alepape1/weather-station-ESP/ESP_monitor_server/ESP_monitor_server.ino

// MeteoStation — Firmware v3
// Compatible con ESP32 (con pantalla ST7789 240×135) y ESP8266 (sin pantalla)
// Sensores: MCP9808, HTU2x, SparkFun MicroPressure, TSL2584/APDS, anemómetro, veleta
// Tres temporizadores independientes: 100ms viento / 1s pantalla / 20s envío

// ── Detección de plataforma ───────────────────────────────────────────────────
#ifdef ESP8266
  #include <ESP8266WiFi.h>
  #include <ESP8266HTTPClient.h>
  #include <WiFiClient.h>
  #include <ArduinoOTA.h>
  #define I2C_SDA          4
  #define I2C_SCL          5
  #define DHTPIN          14   // D5
  #define ADC_VOLTAGE_REF  3.2f
  #define ADC_RANGE        1024.0f
  #define ANEMOMETER_PIN   A0
  #define RELAY_PIN       12   // D6 — GPIO libre para relay electroválvula
#else  // ESP32
  #include "WiFi.h"
  #include <HTTPClient.h>
  #include <WiFiClientSecure.h>
  #include <ArduinoOTA.h>
  #include "driver/rtc_io.h" // Añade esto al principio del archivo
  #define I2C_SDA          21
  #define I2C_SCL          22
  #define DHTPIN           15
  #define ADC_VOLTAGE_REF  3.41f
  #define ADC_RANGE        4096.0f
  #define ANEMOMETER_PIN   37
  #define VANE_PIN         36
  #if DEVICE_PROFILE == PROFILE_METEO
    #define SOIL_PIN         33   // YL-69 humedad suelo (ADC1_CH5) — solo PROFILE_METEO
    #define SOIL_RAW_DRY   3300   // ADC en tierra seca (~0%) — ajustar con valor raw del serial
    #define SOIL_RAW_WET   1000   // ADC en tierra saturada (~100%) — ajustar con valor raw del serial
  #endif
  #define HAS_DISPLAY
  #define RELAY_PIN        26   // GPIO libre para relay electroválvula
#endif

// ── Pipeline — constantes físicas del simulador ───────────────────────────────
#define PIPELINE_STATIC_P   3.50f  // bar — presión estática (válvula cerrada)
#define PIPELINE_DYNAMIC_P  2.80f  // bar — presión dinámica a caudal nominal
#define PIPELINE_NOISE_P    0.04f  // bar — dispersión sensor de presión
#define PIPELINE_NOISE_Q    0.12f  // L/min — dispersión caudalímetro
#define PIPELINE_NOMINAL_Q  5.00f  // L/min — caudal nominal del sistema

#include <SPI.h>
#include <Wire.h>
#include <Adafruit_MCP9808.h>
#include <SparkFun_MicroPressure.h>
#include <DHTesp.h>
#include <ArduinoJson.h>
#include <math.h>
#include "secrets.h"

// ── Perfiles de dispositivo (definir DEVICE_PROFILE en secrets.h) ─────────────
#define PROFILE_METEO       1   // ECU meteorológica — 1 relay (GPIO RELAY_PIN)
#define PROFILE_IRRIGATION  2   // ECU irrigación   — 4 relays (GPIOs RELAY_PIN_1..4)

#ifndef DEVICE_PROFILE
  #define DEVICE_PROFILE PROFILE_METEO
#endif

#if DEVICE_PROFILE == PROFILE_IRRIGATION
  #define RELAY_COUNT 4
  #ifndef RELAY_PIN_1
    // ESP32 4-Relay Board (ESPHome): GPIO32/33/25/26, LED status GPIO23
    #define RELAY_PIN_1 32
    #define RELAY_PIN_2 33
    #define RELAY_PIN_3 25
    #define RELAY_PIN_4 26
  #endif
  static const uint8_t RELAY_PINS[RELAY_COUNT] = {RELAY_PIN_1, RELAY_PIN_2,
                                                   RELAY_PIN_3, RELAY_PIN_4};
#else
  #define RELAY_COUNT 1
  static const uint8_t RELAY_PINS[RELAY_COUNT] = {RELAY_PIN};
#endif

#ifdef HAS_DISPLAY
  #include <TFT_eSPI.h>
#endif

// ── Credenciales (definidas en secrets.h) ─────────────────────────────────────
const char* ssid        = WIFI_SSID;
const char* password    = WIFI_PASSWORD;
const char* server_ip   = SERVER_IP;
const int   server_port = SERVER_PORT;

// ── Pines ─────────────────────────────────────────────────────────────────────
const int ledPin = 2;
#define LED_ON  LOW
#define LED_OFF HIGH

// ── Intervalos ─────────────────────────────────────────────────────────────────
#define WIND_MS       100
#define SCREEN_MS    1000
#define SEND_MS      2000
#define RELAY_MS     2000   // Consulta estado relay cada 2s para respuesta casi inmediata

#ifdef HAS_DISPLAY
#define DISPLAY_TIMEOUT_MS 60000UL  // Apagar pantalla tras 60s sin actividad
#define BTN_LEFT   0                // Botón izquierdo (BOOT), INPUT_PULLUP, activo LOW
#define BTN_RIGHT 35                // Botón derecho, activo LOW
#endif

// ── Objetos ────────────────────────────────────────────────────────────────────
SparkFun_MicroPressure barometer;
Adafruit_MCP9808       tempsensor = Adafruit_MCP9808();
DHTesp                 dht;

#ifdef HAS_DISPLAY
  TFT_eSPI    tft = TFT_eSPI();
  TFT_eSprite spr = TFT_eSprite(&tft);
  unsigned long lastActivityTime = 0;
  bool          displayOn        = true;
#endif

// ── Relay electroválvula(s) ────────────────────────────────────────────────────
// JQC-3FF-S-Z activo-LOW: LOW = relay ON (válvula abierta), HIGH = relay OFF
// relayActive[i] — estado actual de cada relay (índice = bit en bitmask)
bool relayActive[RELAY_COUNT] = {};

// ── Flags de sensor ────────────────────────────────────────────────────────────
bool mcp_ok = false;
bool bar_ok = false;
bool htu_ok = false;
bool dht_ok = false;
bool tsl_ok = false;

// ── Valores medidos ────────────────────────────────────────────────────────────
float  temperatureMCP    = 0;
float  temperatureDHT    = 0;   // HTU2x temperatura
float  humidity          = 0;   // HTU2x humedad
float  temperatureDHT11  = 0;   // DHT11 temperatura
float  humidityDHT11     = 0;   // DHT11 humedad
double pressure          = 0;
float  windSpeed         = 0;
float  windSpeedFiltered = 0;
float  currentWindDirDeg = 0;
float  lightLevel        = 0;
float  soilMoisture      = 0;   // YL-69 — humedad suelo (0=seco, 100=saturado)

// ── Valores simulados (drift lento) ───────────────────────────────────────────
float sim_tempMCP   = 20.5f;
float sim_tempDHT   = 19.8f;
float sim_humidity  = 62.0f;
float sim_tempDHT11 = 20.1f;
float sim_humDHT11  = 60.0f;
float sim_pressure  = 101.3f;
float sim_light     = 300.0f;
float sim_windSpeed = 3.5f;
float sim_windDir        = 180.0f;
float sim_soilMoisture   = 50.0f;

// ── Pipeline simulado ─────────────────────────────────────────────────────────
String pipelineScenario      = "normal";  // actualizado desde el servidor cada 20s
float  sim_pipeline_pressure = PIPELINE_STATIC_P;
float  sim_pipeline_flow     = 0.0f;

static float driftClamp(float v, float mn, float mx, float step) {
  float d = ((float)random(-100, 101) / 100.0f) * step;
  return constrain(v + d, mn, mx);
}

void updateSimulatedValues() {
  sim_tempMCP   = driftClamp(sim_tempMCP,   -10.0f,  45.0f,  0.05f);
  sim_tempDHT   = driftClamp(sim_tempDHT,   -10.0f,  45.0f,  0.05f);
  sim_humidity  = driftClamp(sim_humidity,   20.0f,  95.0f,  0.20f);
  sim_tempDHT11 = driftClamp(sim_tempDHT11, -10.0f,  45.0f,  0.05f);
  sim_humDHT11  = driftClamp(sim_humDHT11,   20.0f,  95.0f,  0.20f);
  sim_pressure  = driftClamp(sim_pressure,   95.0f, 110.0f,  0.02f);
  sim_light     = driftClamp(sim_light,       0.0f, 2000.0f, 5.0f);
  sim_windSpeed = driftClamp(sim_windSpeed,   0.0f,   15.0f, 0.3f);
  sim_windDir        = fmod(sim_windDir + ((float)random(-10, 11) / 10.0f) * 5.0f + 360.0f, 360.0f);
  sim_soilMoisture   = driftClamp(sim_soilMoisture, 0.0f, 100.0f, 0.5f);
}

// ── Pipeline simulator ────────────────────────────────────────────────────────
// Ruido determinista idéntico al de pipeline_sim.py: tres ondas sinusoidales.
// Reproducible y sin random() → facilita comparar resultados con el backend.
static float pipelineNoise(float t_s, int ch) {
  return sinf(t_s *  7.3f + ch * 1.7f) * 0.55f
       + sinf(t_s * 13.1f + ch * 3.2f) * 0.30f
       + sinf(t_s * 31.7f + ch * 5.1f) * 0.15f;
}

void updatePipelineSimValues() {
  float t       = millis() / 1000.0f;
  float p_noise = pipelineNoise(t, 0) * PIPELINE_NOISE_P;
  float q_noise = pipelineNoise(t, 1) * PIPELINE_NOISE_Q;

  if (pipelineScenario == "burst") {
    sim_pipeline_pressure = max(0.0f, 0.25f + p_noise * 0.4f);
    sim_pipeline_flow     = relayActive[0]
      ? max(0.0f, PIPELINE_NOMINAL_Q * 0.08f + fabsf(q_noise) * 0.3f)
      : 0.0f;

  } else if (pipelineScenario == "leak") {
    if (relayActive) {
      sim_pipeline_pressure = max(0.0f, PIPELINE_DYNAMIC_P - 0.18f + p_noise);
      sim_pipeline_flow     = max(0.0f, PIPELINE_NOMINAL_Q - 0.45f + q_noise);
    } else {
      sim_pipeline_pressure = max(0.0f, PIPELINE_STATIC_P - 0.10f + p_noise);
      sim_pipeline_flow     = max(0.0f, 0.28f + fabsf(q_noise) * 0.35f);
    }

  } else {  // "normal"
    if (relayActive) {
      sim_pipeline_pressure = max(0.0f, PIPELINE_DYNAMIC_P + p_noise);
      sim_pipeline_flow     = max(0.0f, PIPELINE_NOMINAL_Q + q_noise);
    } else {
      sim_pipeline_pressure = max(0.0f, PIPELINE_STATIC_P + p_noise);
      sim_pipeline_flow     = max(0.0f, fabsf(q_noise) * 0.05f);
    }
  }
}

// =============================================================================
// HTU2x (HTU21D / HTU20D / SHT21) — temperatura y humedad por I2C
// Dirección fija: 0x40. Sin librería externa.
// =============================================================================
#define HTU2X_ADDR        0x40
#define HTU2X_CMD_TEMP    0xF3   // medir temperatura, no-hold master
#define HTU2X_CMD_HUM     0xF5   // medir humedad,     no-hold master
#define HTU2X_CMD_RESET   0xFE
#define HTU2X_CMD_WR_REG  0xE6   // escribir registro de usuario
#define HTU2X_CMD_RD_REG  0xE7   // leer registro de usuario
// Registro de usuario: bit7+bit0=resolución, bit2=calefactor, bit1=OTP_disable
// 0x02 → 12/14 bit, calefactor OFF, OTP desactivado (default tras reset)
// 0x06 → 12/14 bit, calefactor ON,  OTP desactivado
#define HTU2X_REG_DEFAULT 0x02
#define HTU2X_REG_HEATER  0x06

bool htu_begin() {
  Wire.beginTransmission(HTU2X_ADDR);
  Wire.write(HTU2X_CMD_RESET);
  if (Wire.endTransmission() != 0) return false;
  delay(15);  // tiempo de reset (máx 15 ms según datasheet)
  return true;
}

// Lanza una medición y espera. Devuelve NAN si falla.
static float htu_measure(uint8_t cmd, uint16_t wait_ms) {
  Wire.beginTransmission(HTU2X_ADDR);
  Wire.write(cmd);
  if (Wire.endTransmission() != 0) return NAN;
  delay(wait_ms);
  Wire.requestFrom((uint8_t)HTU2X_ADDR, (uint8_t)3, (uint8_t)1);
  if (Wire.available() < 2) return NAN;
  uint16_t raw = ((uint16_t)Wire.read() << 8) | Wire.read();
  if (Wire.available()) Wire.read();  // descarta CRC
  raw &= 0xFFFC;  // limpia los 2 bits de tipo de medición
  return (float)raw;
}

float htu_readTemp() {
  float raw = htu_measure(HTU2X_CMD_TEMP, 50);
  if (isnan(raw)) return NAN;
  return -46.85f + 175.72f * (raw / 65536.0f);
}

float htu_readHumidity() {
  float raw = htu_measure(HTU2X_CMD_HUM, 20);
  if (isnan(raw)) return NAN;
  return constrain(-6.0f + 125.0f * (raw / 65536.0f), 0.0f, 100.0f);
}

// Activa o desactiva el calefactor interno del HTU2x.
static void htu_set_heater(bool on) {
  Wire.beginTransmission(HTU2X_ADDR);
  Wire.write(HTU2X_CMD_WR_REG);
  Wire.write(on ? HTU2X_REG_HEATER : HTU2X_REG_DEFAULT);
  Wire.endTransmission();
}

// Calentamiento de arranque: activa el calefactor ~3 s para evaporar
// condensación y obtener lecturas de humedad más fiables desde el inicio.
void htu_heater_warmup() {
  Serial.println("HTU2x: calentamiento 3s (evaporar condensacion)...");
  htu_set_heater(true);
  for (int i = 3; i > 0; i--) {
    float t = htu_readTemp();
    float h = htu_readHumidity();
    Serial.printf("  HTU2x heater ON — T:%.1f C  H:%.1f %%  (%ds)\n", t, h, i);
    delay(1000);
  }
  htu_set_heater(false);
  delay(1000);  // estabilización tras apagar calefactor
  Serial.println("HTU2x: calentamiento completado.");
}

// =============================================================================
// Sensor de luz ambiente — autodetección TSL2584 / APDS-9930 (I2C directo)
// Ambos chips usan dirección 0x39 y protocolo CMD=0x80|reg.
// TSL2584:  datos en 0x0C-0x0F, ID en 0x0A (bits[7:4]=0xA)
// APDS-9930: datos en 0x14-0x17, ID en 0x12 (=0x39)
// =============================================================================
#define LIGHT_ADDR     0x39
#define LIGHT_CMD      0x80   // bit CMD obligatorio en el byte de registro

// Registros comunes (misma dirección en ambos chips)
#define LIGHT_CTRL     0x00   // ENABLE / POWER
#define LIGHT_TIMING   0x01   // TIMING (TSL) / ATIME (APDS)

// Registros exclusivos TSL2584
#define TSL_ID_REG     0x0A   // Part number en bits[7:4]; TSL2584 = 0xA
#define TSL_D0L        0x0C   // CH0 low  (visible + IR)
#define TSL_D1L        0x0E   // CH1 low  (IR)

// Registros exclusivos APDS-9930
#define APDS_ID_REG    0x12   // Chip ID; APDS-9930 = 0x39
#define APDS_CDATAL    0x14   // Clear channel low  (visible + IR)
#define APDS_IRDATAL   0x16   // IR channel low

static bool light_is_apds = false;  // se establece en tsl_begin()

static bool light_write(uint8_t reg, uint8_t val) {
  Wire.beginTransmission(LIGHT_ADDR);
  Wire.write(LIGHT_CMD | reg);
  Wire.write(val);
  return Wire.endTransmission() == 0;
}

// Lectura stop-start (más compatible con ESP8266 que repeated-start)
static uint8_t light_read8(uint8_t reg) {
  Wire.beginTransmission(LIGHT_ADDR);
  Wire.write(LIGHT_CMD | reg);
  if (Wire.endTransmission() != 0) return 0xFF;
  Wire.requestFrom((uint8_t)LIGHT_ADDR, (uint8_t)1, (uint8_t)1);
  return Wire.available() ? Wire.read() : 0xFF;
}

static uint16_t light_read16(uint8_t regL) {
  uint16_t lo = light_read8(regL);
  uint16_t hi = light_read8(regL + 1);
  return (hi << 8) | lo;
}

// Enciende el sensor, detecta el tipo y configura la integración.
// Devuelve true si el sensor responde en el bus.
bool tsl_begin() {
  if (!light_write(LIGHT_CTRL, 0x03)) return false;  // Power ON + ALS enable
  delay(10);

  // Autodetección: leer ambos registros de ID y mostrarlos
  uint8_t apds_id = light_read8(APDS_ID_REG);  // 0x12 → 0x39 o 0x30 para APDS-9930
  uint8_t tsl_id  = light_read8(TSL_ID_REG);   // 0x0A → 0xAx para TSL2584
  Serial.printf("[LUZ] ID@0x12=0x%02X  ID@0x0A=0x%02X\n", apds_id, tsl_id);

  // APDS-9930: ID puede ser 0x39 (rev1) o 0x30 (rev0); nibble alto = 0x3
  if ((apds_id & 0xF0) == 0x30) {
    light_is_apds = true;
    // ATIME=0xDB → 37 ciclos × 2.73 ms ≈ 101 ms por conversión
    light_write(LIGHT_TIMING, 0xDB);
    Serial.printf("[LUZ] APDS-9930 detectado (ID=0x%02X)\n", apds_id);
  } else if ((tsl_id & 0xF0) == 0xA0) {
    light_is_apds = false;
    light_write(LIGHT_TIMING, 0x02);  // 402 ms, ganancia 1×
    Serial.printf("[LUZ] TSL2584 detectado (ID=0x%02X)\n", tsl_id);
  } else {
    // ID desconocido — probar APDS-9930 como fallback (más probable en 0x39)
    light_is_apds = true;
    light_write(LIGHT_TIMING, 0xDB);
    Serial.printf("[LUZ] ID desconocido — usando registros APDS-9930 (fallback)\n");
  }

  delay(450);  // Esperar primera integración completa (cubre ambos casos)
  return true;
}

// Devuelve lux estimado a partir del canal visible+IR y el canal IR.
// Usa la fórmula TSL258x (válida también como aproximación para APDS-9930).
float tsl_readLux() {
  uint16_t ch0, ch1;
  if (light_is_apds) {
    ch0 = light_read16(APDS_CDATAL);   // clear (visible + IR)
    ch1 = light_read16(APDS_IRDATAL);  // IR
  } else {
    ch0 = light_read16(TSL_D0L);
    ch1 = light_read16(TSL_D1L);
  }

  if (ch0 == 0) return 0.0f;

  float ratio = (float)ch1 / (float)ch0;
  float lux;

  if      (ratio <= 0.52f) lux = 0.0315f * ch0 - 0.0593f * ch0 * pow(ratio, 1.4f);
  else if (ratio <= 0.65f) lux = 0.0229f * ch0 - 0.0291f * ch1;
  else if (ratio <= 0.80f) lux = 0.0157f * ch0 - 0.0180f * ch1;
  else if (ratio <= 1.30f) lux = 0.00338f * ch0 - 0.00260f * ch1;
  else                     lux = 0.0f;

  return max(0.0f, lux);
}

// ── Filtros media móvil ────────────────────────────────────────────────────────
#define FILTER_SIZE 10

int   anemometerValues[FILTER_SIZE] = {};
int   aneIdx = 0;

float filteredADC(int newVal) {
  anemometerValues[aneIdx] = newVal;
  aneIdx = (aneIdx + 1) % FILTER_SIZE;
  long s = 0;
  for (int i = 0; i < FILTER_SIZE; i++) s += anemometerValues[i];
  return (float)s / FILTER_SIZE;
}

#if defined(SOIL_PIN)
int   soilValues[FILTER_SIZE] = {};
int   soilIdx = 0;

float filteredSoilADC(int newVal) {
  soilValues[soilIdx] = newVal;
  soilIdx = (soilIdx + 1) % FILTER_SIZE;
  long s = 0;
  for (int i = 0; i < FILTER_SIZE; i++) s += soilValues[i];
  return (float)s / FILTER_SIZE;
}
#endif

float adcToWindSpeed(float adc) {
  float v = adc * (ADC_VOLTAGE_REF / ADC_RANGE);
  return (v / ADC_VOLTAGE_REF) * 30.0f;
}

#ifdef HAS_DISPLAY
float adcToWindDeg(int adc) {
  float d = (adc / ADC_RANGE) * 360.0f;
  if (d >= 337.5f || d < 22.5f) return 0.0f;
  if (d < 67.5f)                 return 45.0f;
  if (d < 112.5f)                return 90.0f;
  if (d < 157.5f)                return 135.0f;
  if (d < 202.5f)                return 180.0f;
  if (d < 247.5f)                return 225.0f;
  if (d < 292.5f)                return 270.0f;
  return 315.0f;
}
#else
float adcToWindDeg(int) { return 0.0f; }
#endif

const char* degToCompass(float d) {
  const char* dirs[] = {"N","NE","E","SE","S","SO","O","NO"};
  return dirs[((int)(d + 22.5f) / 45) % 8];
}

// ── FreeRTOS (solo ESP32) — declarado aquí para estar disponible antes de su uso ──
#ifndef ESP8266
volatile bool        isUpdatingOTA = false;
portMUX_TYPE         windMux       = portMUX_INITIALIZER_UNLOCKED;
SemaphoreHandle_t    dataMutex     = nullptr;
TaskHandle_t         networkTaskHandle = nullptr;
#endif

// ── Promedio vectorial de dirección ────────────────────────────────────────────
float windSumX = 0, windSumY = 0;
int   windSampleCount = 0;
float finalAvgWindDir = 0;

void accumulateWindVector(float deg) {
  float r = deg * PI / 180.0f;
#ifndef ESP8266
  portENTER_CRITICAL(&windMux);
#endif
  windSumX += cos(r);
  windSumY += sin(r);
  windSampleCount++;
#ifndef ESP8266
  portEXIT_CRITICAL(&windMux);
#endif
}

float calcAndResetWindVector() {
#ifndef ESP8266
  portENTER_CRITICAL(&windMux);
#endif
  if (windSampleCount == 0) {
#ifndef ESP8266
    portEXIT_CRITICAL(&windMux);
#endif
    return 0;
  }
  float deg = atan2(windSumY, windSumX) * 180.0f / PI;
  if (deg < 0) deg += 360.0f;
  windSumX = windSumY = 0;
  windSampleCount = 0;
#ifndef ESP8266
  portEXIT_CRITICAL(&windMux);
#endif
  return deg;
}

// ── Estado ────────────────────────────────────────────────────────────────────
bool lastServerOK    = false;
unsigned long lastSendTime   = 0;
unsigned long lastScreenTime = 0;


// ── Info estática del hardware ────────────────────────────────────────────────
void printHardwareInfo() {
  Serial.println("\n=== Hardware Info ===");
#ifdef ESP8266
  Serial.printf("Chip         : ESP8266 (ID=0x%08X)\n", ESP.getChipId());
#else
  Serial.printf("Chip         : %s rev%d\n", ESP.getChipModel(), ESP.getChipRevision());
#endif
  Serial.printf("CPU          : %d MHz\n",      ESP.getCpuFreqMHz());
  Serial.printf("Flash        : %d MB\n",        ESP.getFlashChipSize() / (1024 * 1024));
  Serial.printf("Free Heap    : %d bytes\n",     ESP.getFreeHeap());
  Serial.printf("SDK          : %s\n",           ESP.getSdkVersion());
  Serial.printf("MAC          : %s\n",           WiFi.macAddress().c_str());
  Serial.printf("IP           : %s\n",           WiFi.localIP().toString().c_str());
  Serial.println("====================");
}

void postDeviceInfo() {
  JsonDocument doc;
#ifdef ESP8266
  doc["chip_model"]    = "ESP8266";
  doc["chip_revision"] = 0;
#else
  doc["chip_model"]    = ESP.getChipModel();
  doc["chip_revision"] = (int)ESP.getChipRevision();
#endif
  doc["cpu_freq_mhz"]  = ESP.getCpuFreqMHz();
  doc["flash_size_mb"] = ESP.getFlashChipSize() / (1024 * 1024);
  doc["sdk_version"]   = ESP.getSdkVersion();
  doc["mac_address"]   = WiFi.macAddress();
  doc["ip_address"]    = WiFi.localIP().toString();
  doc["relay_count"]   = RELAY_COUNT;

  String json;
  serializeJson(doc, json);

  String url = "https://" + String(server_ip) + "/api/device_info";
#ifdef ESP8266
  WiFiClient wifiClient;
  HTTPClient http;
  http.setTimeout(10000);
  http.begin(wifiClient, url);
#else
  WiFiClientSecure client;
  client.setInsecure();
  client.setHandshakeTimeout(10);
  HTTPClient http;
  http.setTimeout(10000);
  http.begin(client, url);
#endif
  http.addHeader("Content-Type", "application/json");
  int code = http.POST(json);
  http.end();
  Serial.printf("[DeviceInfo] POST → %d\n", code);
}

// ── HTTP helpers ──────────────────────────────────────────────────────────────
String httpGet(const String& url, int timeoutMs = 10000) {
#ifdef ESP8266
  WiFiClient wifiClient;
  HTTPClient http;
  http.setTimeout(timeoutMs);
  http.begin(wifiClient, url);
#else
  WiFiClientSecure client;
  client.setInsecure();
  client.setHandshakeTimeout(timeoutMs / 1000);
  HTTPClient http;
  http.setTimeout(timeoutMs);
  http.begin(client, url);
#endif
  int code = http.GET();
  String body = "";
  if (code == 200) body = http.getString();
  http.end();
  body.trim();
  return body;
}

void checkRelayCommand() {
  String url = "https://" + String(server_ip)
               + "/api/relay/command?mac=" + WiFi.macAddress();
  String response = httpGet(url, 2000);
  if (response.length() == 0) return;

  int bitmask = response.toInt();
  bool changed = false;
  for (int i = 0; i < RELAY_COUNT; i++) {
    bool desired = (bitmask >> i) & 1;
    if (desired != relayActive[i]) {
      relayActive[i] = desired;
      // JQC-3FF-S-Z activo-LOW: LOW = relay ON, HIGH = relay OFF
      digitalWrite(RELAY_PINS[i], desired ? LOW : HIGH);
      Serial.printf("[Relay %d] %s\n", i, desired ? "ON" : "OFF");
      changed = true;
    }
  }
  if (changed) {
    int actualMask = 0;
    for (int i = 0; i < RELAY_COUNT; i++) {
      if (relayActive[i]) actualMask |= (1 << i);
    }
    httpPost("https://" + String(server_ip) + "/api/relay/ack", String(actualMask));
  }
}

bool httpPost(const String& url, const String& body) {
#ifdef ESP8266
  WiFiClient wifiClient;
  HTTPClient http;
  http.setTimeout(10000);
  http.begin(wifiClient, url);
#else
  WiFiClientSecure client;
  client.setInsecure();
  client.setHandshakeTimeout(10);
  HTTPClient http;
  http.setTimeout(10000);
  http.begin(client, url);
#endif
  http.addHeader("Content-Type", "text/plain");
  http.addHeader("X-Device-MAC", WiFi.macAddress());
  int code = http.POST(body);
  http.end();
  return (code == 200 || code == 201);
}

// =============================================================================
// PANTALLA TFT (solo ESP32)
// =============================================================================
#ifdef HAS_DISPLAY

// Paleta Aquantia: azul corporativo #5ab4e0 · cabecera navy #0d3a6e
#define C_BG      0x0841   // fondo general    ~#0d0d0d
#define C_CARD    0x1082   // fondo tarjeta    ~#101010
#define C_HDR     0x09CD   // cabecera         ~#0d3a6e (navy Aquantia)
#define C_BORDER  0x2124   // borde tarjeta
#define C_TEXT    0xFFFF   // texto principal  blanco
#define C_LABEL   0x7BEF   // etiqueta gris claro
#define C_SIM     0xFD20   // simulado         naranja
#define C_REAL    0x5DBC   // dato real        #5ab4e0 (azul Aquantia)
#define C_RED     0xF800   // error/alerta     rojo

// Layout 240×135 — 2 filas × 3 cols + fila extra para luz
// Fila 0-1: misma cuadrícula 2×3 de siempre (tarjetas 79×57)
// La luz se muestra como barra inferior de 16px en la cabecera (valor en header)
#define HDR_H    18
#define CARD_W   79
#define CARD_H   57

static int cardX(int col) { return col * (CARD_W + 1); }
static int cardY(int row) { return HDR_H + row * (CARD_H + 2); }

void iconThermometer(int cx, int cy, uint16_t col) {
  spr.fillRoundRect(cx - 2, cy - 7, 5, 10, 2, col);
  spr.fillCircle(cx, cy + 5, 4, col);
  spr.drawFastVLine(cx, cy - 7, 8, C_CARD);
}

void iconDrop(int cx, int cy, uint16_t col) {
  spr.fillCircle(cx, cy + 4, 4, col);
  for (int i = 0; i <= 7; i++) {
    int hw = (7 - i) / 2;
    spr.drawFastHLine(cx - hw, cy - 3 + i, hw * 2 + 1, col);
  }
}

void iconGauge(int cx, int cy, uint16_t col) {
  spr.drawCircle(cx, cy, 7, col);
  spr.drawLine(cx, cy, cx + 4, cy - 4, col);
  spr.fillCircle(cx, cy, 2, col);
  spr.drawFastHLine(cx - 5, cy + 5, 11, col);
}

void iconWind(int cx, int cy, uint16_t col) {
  spr.drawFastHLine(cx - 6, cy - 3, 12, col);
  spr.drawLine(cx + 6, cy - 3, cx + 8, cy - 1, col);
  spr.drawFastHLine(cx - 6, cy,     10, col);
  spr.drawFastHLine(cx - 6, cy + 3, 12, col);
}

void iconCompass(int cx, int cy, uint16_t col) {
  spr.drawCircle(cx, cy, 7, col);
  spr.fillTriangle(cx, cy - 6, cx - 2, cy, cx + 2, cy, col);
  spr.fillTriangle(cx, cy + 6, cx - 2, cy, cx + 2, cy, C_LABEL);
}

// Icono sol simple para luz
void iconSun(int cx, int cy, uint16_t col) {
  spr.fillCircle(cx, cy, 4, col);
  for (int a = 0; a < 360; a += 45) {
    float r = a * PI / 180.0f;
    int x1 = cx + (int)(6 * cos(r));
    int y1 = cy + (int)(6 * sin(r));
    int x2 = cx + (int)(9 * cos(r));
    int y2 = cy + (int)(9 * sin(r));
    spr.drawLine(x1, y1, x2, y2, col);
  }
}

typedef void (*IconFn)(int, int, uint16_t);
IconFn iconFns[6] = {
  iconThermometer,
  iconThermometer,
  iconDrop,
  iconGauge,
  iconWind,
  iconCompass,
};

void drawCard(int col, int row,
              const char* label,
              float value, const char* unit,
              bool simulated,
              bool showCompass = false) {
  int x = cardX(col);
  int y = cardY(row);

  spr.fillRoundRect(x + 1, y + 1, CARD_W - 2, CARD_H - 2, 4, C_CARD);
  spr.drawRoundRect(x, y, CARD_W, CARD_H, 4, C_BORDER);

  uint16_t accentCol = simulated ? C_SIM : C_REAL;
  spr.fillRoundRect(x + 1, y + 1, CARD_W - 2, 3, 2, accentCol);

  int idx = row * 3 + col;
  iconFns[idx](x + 10, y + 13, accentCol);

  spr.setTextColor(C_LABEL, C_CARD);
  spr.drawString(label, x + 22, y + 5, 1);

  spr.setTextColor(C_TEXT, C_CARD);
  char buf[12];
  snprintf(buf, sizeof(buf), showCompass ? "%.0f" : "%.1f", value);
  spr.drawString(buf, x + 4, y + 18, 4);

  spr.setTextColor(C_LABEL, C_CARD);
  spr.drawString(unit, x + 4, y + CARD_H - 13, 1);

  if (showCompass) {
    spr.setTextColor(accentCol, C_CARD);
    spr.drawString(degToCompass(value), x + 42, y + CARD_H - 13, 2);
  }

  const char* badge = simulated ? "[SIM]" : "[OK]";
  spr.setTextColor(accentCol, C_CARD);
  spr.drawRightString(badge, x + CARD_W - 2, y + CARD_H - 13, 1);
}

void drawScreen() {
  spr.fillSprite(C_BG);

  // Cabecera con luz integrada a la derecha del título
  spr.fillRect(0, 0, 240, HDR_H, C_HDR);
  spr.setTextColor(C_TEXT, C_HDR);
  spr.drawString("METEOSTATION", 6, 4, 2);

  // Luz en la cabecera (icono + valor lux)
  uint16_t luxCol = tsl_ok ? C_REAL : C_SIM;
  iconSun(118, 9, luxCol);
  char luxBuf[10];
  snprintf(luxBuf, sizeof(luxBuf), "%.0flx", lightLevel);
  spr.setTextColor(luxCol, C_HDR);
  spr.drawString(luxBuf, 130, 5, 1);

  if (WiFi.status() == WL_CONNECTED) {
    spr.setTextColor(C_REAL, C_HDR);
    spr.drawString("WiFi", 168, 5, 1);
  } else {
    spr.setTextColor(C_RED, C_HDR);
    spr.drawString("NoWiFi", 157, 5, 1);
  }

  uint16_t srvCol = lastServerOK ? C_REAL : C_RED;
  spr.fillCircle(230, 9, 5, srvCol);
  spr.drawCircle(230, 9, 5, C_TEXT);

  drawCard(0, 0, "T.EXT",   temperatureMCP,     "C",    !mcp_ok);
  drawCard(1, 0, "T.INT",   temperatureDHT,     "C",    !htu_ok);
  drawCard(2, 0, "HUMEDAD", humidity,           "%",    !htu_ok);
  drawCard(0, 1, "PRESION", (float)pressure,    "KPa",  !bar_ok);
  drawCard(1, 1, "VIENTO",  windSpeedFiltered,  "m/s",  false);
  drawCard(2, 1, "DIRECC.", currentWindDirDeg,  "deg",  false, true);

  spr.pushSprite(0, 0);
}

void drawBootScreen(const char* wifiMsg) {
  spr.fillSprite(C_BG);

  spr.fillRect(0, 0, 240, HDR_H, C_HDR);
  spr.setTextColor(C_TEXT, C_HDR);
  spr.drawCentreString("METEOSTATION  v3", 120, 4, 2);

  struct { const char* lbl; bool ok; } sensors[4] = {
    { "MCP9808  (T.Ext)", mcp_ok },
    { "Barometro       ", bar_ok },
    { "HTU2x    (T+H)  ", htu_ok },
    { "LuzAmb   (0x39) ", tsl_ok },
  };

  for (int i = 0; i < 4; i++) {
    int y = 22 + i * 24;
    spr.setTextColor(C_LABEL, C_BG);
    spr.drawString(sensors[i].lbl, 8, y, 2);

    uint16_t badgeCol    = sensors[i].ok ? C_REAL : C_SIM;
    const char* badgeTxt = sensors[i].ok ? "  REAL  " : "  SIM  ";
    spr.fillRoundRect(163, y, 60, 16, 3, badgeCol);
    spr.setTextColor(TFT_BLACK, badgeCol);
    spr.drawCentreString(badgeTxt, 193, y + 4, 1);
  }

  spr.setTextColor(C_LABEL, C_BG);
  spr.drawCentreString(wifiMsg, 120, 120, 2);

  spr.pushSprite(0, 0);
}

#endif  // HAS_DISPLAY

// =============================================================================
// TAREA DE RED — Core 0 (solo ESP32)
// Gestiona OTA, relay polling y HTTP POST sin bloquear sensores/display (Core 1)
// =============================================================================
#ifndef ESP8266
void networkTask(void* pvParameters) {
  static bool   deviceInfoSent = false;
  static unsigned long lastRelayCheck = 0;
  static unsigned long lastSendTime   = 0;

  for (;;) {
    ArduinoOTA.handle();  // siempre primero, alta frecuencia

    if (isUpdatingOTA) {
      vTaskDelay(10 / portTICK_PERIOD_MS);
      continue;
    }

    if (WiFi.status() != WL_CONNECTED) {
      WiFi.reconnect();
      vTaskDelay(500 / portTICK_PERIOD_MS);
      continue;
    }

    unsigned long now = millis();

    // Device info — una sola vez tras conectar
    if (!deviceInfoSent) {
      postDeviceInfo();
      deviceInfoSent = true;
    }

    // Relay poll cada 2s
    if (now - lastRelayCheck >= RELAY_MS) {
      checkRelayCommand();
      lastRelayCheck = now;
    }

    // HTTP POST cada 20s — captura snapshot con mutex
    if (now - lastSendTime >= SEND_MS) {
      // Snapshot de valores sensor bajo mutex (lectura atómica)
      float snap_tempMCP, snap_pressure, snap_tempDHT, snap_humidity;
      float snap_windSpeed, snap_windDir, snap_windSpeedFilt, snap_avgWindDir;
      float snap_light, snap_tempDHT11, snap_humDHT11, snap_soil;
      long  snap_heap;
      int   snap_rssi;
      long  snap_uptime;
      int   snap_relayMask = 0;

      if (xSemaphoreTake(dataMutex, pdMS_TO_TICKS(50)) == pdTRUE) {
        snap_tempMCP       = temperatureMCP;
        snap_pressure      = (float)pressure;
        snap_tempDHT       = temperatureDHT;
        snap_humidity      = humidity;
        snap_windSpeed     = windSpeed;
        snap_windDir       = currentWindDirDeg;
        snap_windSpeedFilt = windSpeedFiltered;
        snap_avgWindDir    = calcAndResetWindVector();
        snap_light         = lightLevel;
        snap_tempDHT11     = temperatureDHT11;
        snap_humDHT11      = humidityDHT11;
        snap_soil          = soilMoisture;
        snap_heap          = (long)ESP.getFreeHeap();
        snap_rssi          = WiFi.RSSI();
        snap_uptime        = (long)(millis() / 1000);
        for (int i = 0; i < RELAY_COUNT; i++)
          if (relayActive[i]) snap_relayMask |= (1 << i);
        xSemaphoreGive(dataMutex);
      }

      String url = "https://" + String(server_ip) + "/send_message";
      char msg[256];
      snprintf(msg, sizeof(msg),
        "%.2f,%.2f,%.2f,%.2f,%.2f,%.2f,%.2f,%.2f,%.2f,%.2f,%.2f,%d,%ld,%ld,%d,%.2f",
        snap_tempMCP, snap_pressure, snap_tempDHT, snap_humidity,
        snap_windSpeed, snap_windDir, snap_windSpeedFilt, snap_avgWindDir,
        snap_light, snap_tempDHT11, snap_humDHT11,
        snap_rssi, snap_heap, snap_uptime, snap_relayMask, snap_soil
      );

      Serial.printf("[NET] TX: %s\n", msg);
      digitalWrite(ledPin, LED_ON);
      bool ok = httpPost(url, String(msg));
      digitalWrite(ledPin, LED_OFF);
      Serial.printf("[NET] HTTP %s\n", ok ? "200 OK" : "ERROR");

      lastServerOK = ok;
      lastSendTime = now;
    }

    vTaskDelay(10 / portTICK_PERIOD_MS);
  }
}
#endif

// =============================================================================
// SETUP
// =============================================================================
void setup() {
  Serial.begin(115200);
  delay(200);
  setCpuFrequencyMhz(160);
  Serial.println("\n\n=== MeteoStation BOOT ===");

  Serial.println("Iniciando I2C...");
  Wire.begin(I2C_SDA, I2C_SCL);
  Serial.println("I2C OK");

  // Escaner I2C — detecta todos los dispositivos en el bus
  Serial.println("Escaneando bus I2C...");
  int found = 0;
  for (uint8_t addr = 1; addr < 127; addr++) {
    Wire.beginTransmission(addr);
    if (Wire.endTransmission() == 0) {
      Serial.printf("  Dispositivo en 0x%02X\n", addr);
      found++;
    }
    delay(2);
  }
  if (found == 0) Serial.println("  Ningun dispositivo encontrado");
  else Serial.printf("  Total: %d dispositivos\n", found);

  pinMode(ledPin, OUTPUT);
  digitalWrite(ledPin, LED_OFF);

  // Relay(s) — arrancar siempre en OFF (seguro)
  // JQC-3FF-S-Z activo-LOW: HIGH = relay OFF (válvula cerrada)
  for (int i = 0; i < RELAY_COUNT; i++) {
    pinMode(RELAY_PINS[i], OUTPUT);
    digitalWrite(RELAY_PINS[i], HIGH);  // HIGH = OFF para relay activo-LOW
  }
  Serial.printf("%d relay(s) inicializados en OFF (HIGH)\n", RELAY_COUNT);

#if defined(ESP32) && !defined(ESP8266)
  analogReadResolution(12);
  #if defined(SOIL_PIN)
  pinMode(SOIL_PIN, ANALOG);
  analogSetPinAttenuation(SOIL_PIN, ADC_11db);
  Serial.printf("SOIL GPIO%d configurado como ANALOG (11dB)\n", SOIL_PIN);
  #endif
#endif
#ifdef HAS_DISPLAY
  tft.init();
  tft.setRotation(1);
  tft.fillScreen(TFT_BLACK);
  spr.createSprite(240, 135);
  spr.setSwapBytes(true);
  pinMode(BTN_LEFT,  INPUT_PULLUP);
  pinMode(BTN_RIGHT, INPUT);
  lastActivityTime = millis();
#endif

  mcp_ok = tempsensor.begin(0x19);
  if (mcp_ok) {
    tempsensor.setResolution(3);
    Serial.println("MCP9808 OK");
  } else {
    Serial.println("MCP9808 no detectado — modo simulacion");
    temperatureMCP = sim_tempMCP;
  }

  bar_ok = barometer.begin();
  if (bar_ok) {
    Serial.println("Barometro OK");
  } else {
    Serial.println("Barometro no detectado — modo simulacion");
    pressure = sim_pressure;
  }

  htu_ok = htu_begin();
  if (htu_ok) {
    htu_heater_warmup();
    float t = htu_readTemp();
    float h = htu_readHumidity();
    if (!isnan(t) && !isnan(h)) {
      temperatureDHT = t;
      humidity       = h;
      Serial.printf("HTU2x OK — T:%.1f C  H:%.1f %%\n", t, h);
    } else {
      htu_ok = false;
    }
  }
  if (!htu_ok) {
    Serial.println("HTU2x no detectado — modo simulacion");
    temperatureDHT = sim_tempDHT;
    humidity       = sim_humidity;
  }

  // DHT11
  dht.setup(DHTPIN, DHTesp::DHT11);
  delay(dht.getMinimumSamplingPeriod());
  {
    TempAndHumidity th = dht.getTempAndHumidity();
    dht_ok = (dht.getStatus() == DHTesp::ERROR_NONE);
    if (dht_ok) {
      temperatureDHT11 = th.temperature;
      humidityDHT11    = th.humidity;
      Serial.println("DHT11 OK");
    } else {
      Serial.println("DHT11 no detectado — modo simulacion");
      temperatureDHT11 = sim_tempDHT11;
      humidityDHT11    = sim_humDHT11;
    }
  }

  // TSL2584 — el begin() ya espera la primera integración (450ms)
  tsl_ok = tsl_begin();
  if (tsl_ok) {
    Serial.println("Sensor luz OK");
    lightLevel = tsl_readLux();
  } else {
    Serial.println("Sensor luz no detectado — modo simulacion");
    lightLevel = sim_light;
  }

#if defined(SOIL_PIN)
  {
    int raw = analogRead(SOIL_PIN);
    // Precalentar el filtro con la lectura inicial
    for (int i = 0; i < FILTER_SIZE; i++) soilValues[i] = raw;
    soilMoisture = constrain(
      (float)(SOIL_RAW_DRY - raw) / (SOIL_RAW_DRY - SOIL_RAW_WET) * 100.0f,
      0.0f, 100.0f
    );
    Serial.printf("YL-69 OK — suelo: %.1f %% (ADC raw=%d)\n", soilMoisture, raw);
  }
#endif

#ifdef ESP8266
  Serial.println("Plataforma: ESP8266 (sin pantalla, sin veleta)");
#else
  Serial.println("Plataforma: ESP32 (con pantalla TFT)");
#endif

#ifdef HAS_DISPLAY
  drawBootScreen("Conectando WiFi...");
#endif

  Serial.println("Conectando WiFi...");
  WiFi.begin(ssid, password);
  int tries = 0;
  while (WiFi.status() != WL_CONNECTED && tries < 20) {
    delay(500);
#ifdef ESP8266
    yield();
#endif
    Serial.print(".");
    tries++;
  }
  Serial.println();

  if (WiFi.status() == WL_CONNECTED) {
    Serial.println("WiFi OK: " + WiFi.localIP().toString());

    // ── OTA (Over-The-Air) ──────────────────────────────────────────────────
#ifdef ESP8266
    ArduinoOTA.setHostname("meteostation-esp8266");
#else
    ArduinoOTA.setHostname("meteostation-esp32");
#endif
    // Contraseña OTA opcional — definir OTA_PASSWORD en secrets.h para activarla
#ifdef OTA_PASSWORD
    ArduinoOTA.setPassword(OTA_PASSWORD);
#endif
    ArduinoOTA.onStart([]() {
      isUpdatingOTA = true;
      String type = (ArduinoOTA.getCommand() == U_FLASH) ? "firmware" : "filesystem";
      Serial.printf("\n[OTA] Inicio de actualización (%s) — relays a OFF por seguridad\n", type.c_str());
      // Apagar todos los relays por seguridad durante el flash
      for (int i = 0; i < RELAY_COUNT; i++) digitalWrite(RELAY_PINS[i], HIGH);
    });
    ArduinoOTA.onEnd([]() {
      Serial.println("\n[OTA] Actualización completada — reiniciando");
    });
    ArduinoOTA.onProgress([](unsigned int progress, unsigned int total) {
      Serial.printf("[OTA] %u%% (%u/%u bytes)\r", progress * 100 / total, progress, total);
    });
    ArduinoOTA.onError([](ota_error_t error) {
      isUpdatingOTA = false;
      const char* msg = "Desconocido";
      switch (error) {
        case OTA_AUTH_ERROR:    msg = "Fallo de autenticacion";  break;
        case OTA_BEGIN_ERROR:   msg = "Fallo al iniciar";        break;
        case OTA_CONNECT_ERROR: msg = "Fallo de conexion";       break;
        case OTA_RECEIVE_ERROR: msg = "Fallo al recibir datos";  break;
        case OTA_END_ERROR:     msg = "Fallo al finalizar";      break;
      }
      Serial.printf("[OTA] ERROR %u: %s\n", error, msg);
    });
    ArduinoOTA.begin();

#ifndef ESP8266
    // FreeRTOS: crear tarea de red en Core 0
    dataMutex = xSemaphoreCreateMutex();
    xTaskCreatePinnedToCore(
      networkTask,        // función
      "NetworkTask",      // nombre
      8192,               // stack (bytes)
      nullptr,            // parámetros
      2,                  // prioridad (más alta que loop=1)
      &networkTaskHandle, // handle
      0                   // Core 0
    );
    Serial.println("NetworkTask creada en Core 0");
#endif
    WiFi.setSleep(true);  // Modem Sleep: ahorra ~15-20mA entre transmisiones
    Serial.println("OTA listo — hostname: " +
#ifdef ESP8266
      String("meteostation-esp8266")
#else
      String("meteostation-esp32")
#endif
    );
    // ── Fin OTA ─────────────────────────────────────────────────────────────

    printHardwareInfo();

#ifdef HAS_DISPLAY
    drawBootScreen(("IP: " + WiFi.localIP().toString()).c_str());
#endif
  } else {
    Serial.println("Sin WiFi — continuando sin conexion (OTA no disponible)");
#ifdef HAS_DISPLAY
    drawBootScreen("Sin WiFi — modo offline");
#endif
  }

#ifdef HAS_DISPLAY
  delay(2500);
#endif
}

// =============================================================================
// LOOP — Core 1: sensores + display (sin red)
// En ESP8266 incluye también la red (sin FreeRTOS).
// =============================================================================
void loop() {
#ifdef ESP8266
  ArduinoOTA.handle();
#endif

  unsigned long now = millis();

#ifdef HAS_DISPLAY
  // Botones — cualquiera enciende la pantalla y resetea el timer
  if (!digitalRead(BTN_LEFT) || !digitalRead(BTN_RIGHT)) {
    if (!displayOn) {
      digitalWrite(TFT_BL, HIGH);
      displayOn = true;
    }
    lastActivityTime = now;
  }
  // Timeout — apagar pantalla tras DISPLAY_TIMEOUT_MS sin actividad
  if (displayOn && (now - lastActivityTime >= DISPLAY_TIMEOUT_MS)) {
    digitalWrite(TFT_BL, LOW);
    displayOn = false;
  }
#endif

  // ── 1. Lectura ADC viento (cada 100ms) ──────────────────────────────────────
  static unsigned long lastWindRead = 0;
  if (now - lastWindRead >= WIND_MS) {
#ifdef HAS_DISPLAY
    int rawAne = analogRead(ANEMOMETER_PIN);
    float filtAne     = filteredADC(rawAne);
    windSpeed         = adcToWindSpeed((float)rawAne);
    windSpeedFiltered = adcToWindSpeed(filtAne);
    int rawVane       = analogRead(VANE_PIN);
    currentWindDirDeg = adcToWindDeg(rawVane);
#else
    // ESP8266 sin veleta: anemómetro y veleta simulados
    windSpeed         = sim_windSpeed;
    windSpeedFiltered = sim_windSpeed;
    currentWindDirDeg = sim_windDir;
#endif

    accumulateWindVector(currentWindDirDeg);
    lastWindRead = now;
  }

  // ── 2. Sensores I2C (MCP9808, HTU2x, barometro, luz) + pantalla (cada 1s) ───
  if (now - lastScreenTime >= SCREEN_MS) {
#ifndef ESP8266
    bool hasMutex = (dataMutex && xSemaphoreTake(dataMutex, pdMS_TO_TICKS(20)) == pdTRUE);
#endif

    // MCP9808
    if (mcp_ok) {
      tempsensor.wake();
      float t = tempsensor.readTempC();
      tempsensor.shutdown_wake(1);
      if (!isnan(t) && t > -40.0f) {
        temperatureMCP = t;
      } else {
        mcp_ok = false;
        Serial.println("MCP9808 fallo en lectura — cambiando a simulacion");
      }
    }
    if (!mcp_ok) temperatureMCP = sim_tempMCP;

    // Barómetro
    if (bar_ok) {
      double p = barometer.readPressure(KPA);
      if (p > 50.0) {
        pressure = p;
      } else {
        bar_ok = false;
        Serial.println("Barometro fallo en lectura — cambiando a simulacion");
      }
    }
    if (!bar_ok) pressure = sim_pressure;

    // HTU2x
    if (htu_ok) {
      float t = htu_readTemp();
      float h = htu_readHumidity();
      if (!isnan(t) && !isnan(h)) {
        temperatureDHT = t;
        humidity       = h;
      } else {
        htu_ok = false;
        Serial.println("HTU2x fallo en lectura — cambiando a simulacion");
      }
    }
    if (!htu_ok) {
      temperatureDHT = sim_tempDHT;
      humidity       = sim_humidity;
    }

    // DHT11
    {
      TempAndHumidity th = dht.getTempAndHumidity();
      if (dht.getStatus() == DHTesp::ERROR_NONE) {
        dht_ok           = true;
        temperatureDHT11 = th.temperature;
        humidityDHT11    = th.humidity;
      } else {
        dht_ok = false;
      }
    }
    if (!dht_ok) {
      temperatureDHT11 = sim_tempDHT11;
      humidityDHT11    = sim_humDHT11;
    }

    // TSL2584
    if (tsl_ok) {
      float lux = tsl_readLux();
      if (lux >= 0.0f) {
        lightLevel = lux;
      } else {
        tsl_ok = false;
        Serial.println("TSL2584 fallo en lectura — cambiando a simulacion");
      }
    }
    if (!tsl_ok) lightLevel = sim_light;

#if defined(SOIL_PIN)
    {
      int raw = analogRead(SOIL_PIN);
      float filtRaw = filteredSoilADC(raw);
      soilMoisture = constrain(
        (float)(SOIL_RAW_DRY - filtRaw) / (SOIL_RAW_DRY - SOIL_RAW_WET) * 100.0f,
        0.0f, 100.0f
      );
    }
#else
    soilMoisture = sim_soilMoisture;
#endif

    updateSimulatedValues();

#ifndef ESP8266
    if (hasMutex) xSemaphoreGive(dataMutex);
#endif

#ifdef HAS_DISPLAY
    drawScreen();
#else
    Serial.printf("[1s] T:%.1f Tb:%.1f H:%.1f D11T:%.1f D11H:%.1f P:%.2f W:%.2f D:%.0f Lux:%.1f Soil:%.1f%%\n",
      temperatureMCP, temperatureDHT, humidity,
      temperatureDHT11, humidityDHT11,
      (float)pressure, windSpeedFiltered, currentWindDirDeg, lightLevel, soilMoisture);
#endif

    lastScreenTime = now;
  }

#ifdef ESP8266
  // ── ESP8266: red en el loop() (sin FreeRTOS) ─────────────────────────────────
  static unsigned long lastRelayCheck8266 = 0;
  if (now - lastRelayCheck8266 >= RELAY_MS && WiFi.status() == WL_CONNECTED) {
    checkRelayCommand();
    lastRelayCheck8266 = now;
  }

  static bool deviceInfoSent8266 = false;
  if (!deviceInfoSent8266 && WiFi.status() == WL_CONNECTED) {
    postDeviceInfo();
    deviceInfoSent8266 = true;
  }

  static unsigned long lastSendTime8266 = 0;
  if (now - lastSendTime8266 >= SEND_MS) {
    finalAvgWindDir = calcAndResetWindVector();
    bool ok = false;
    if (WiFi.status() == WL_CONNECTED) {
      String url = "https://" + String(server_ip) + "/send_message";
      char msg[256];
      int relayMask = 0;
      for (int i = 0; i < RELAY_COUNT; i++) if (relayActive[i]) relayMask |= (1 << i);
      snprintf(msg, sizeof(msg),
        "%.2f,%.2f,%.2f,%.2f,%.2f,%.2f,%.2f,%.2f,%.2f,%.2f,%.2f,%d,%ld,%ld,%d,%.2f",
        temperatureMCP, (float)pressure, temperatureDHT, humidity,
        windSpeed, currentWindDirDeg, windSpeedFiltered, finalAvgWindDir,
        lightLevel, temperatureDHT11, humidityDHT11,
        WiFi.RSSI(), (long)ESP.getFreeHeap(), (long)(millis()/1000),
        relayMask, soilMoisture
      );
      ok = httpPost(url, String(msg));
    } else {
      WiFi.reconnect();
    }
    lastServerOK = ok;
    lastSendTime8266 = now;
  }
#endif
}
