alepape1/weather-station-ESP/(commit log)

2026-03-13 Actualiza firmware a v2 y reescribe documentación completa
    ESP_monitor_server.ino:
    - Loop refactorizado en tres bloques independientes con millis():
    100ms lectura sensores, 1s pantalla TFT, 20s envío HTTP
    - HTTP solo se crea cuando toca enviar (elimina bug de conexiones TCP
    abandonadas en cada iteración del loop)
    - Dirección del viento con promedio vectorial (sin/cos + atan2) en lugar
    de media móvil simple, que es matemáticamente incorrecto para ángulos
    - Reconexión WiFi automática si se pierde la red
    - Timeout HTTP de 3s para evitar bloqueos si el servidor no responde
    - WiFi en setup con límite de 20 intentos (no bloquea infinito)
    - IP del servidor actualizada a 192.168.1.42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
    [ESP_monitor_server.ino]
2026-03-13 Firmware v3: simulación por sensor, dashboard 320×170 con badges REAL/SIM
    - Detección independiente de MCP9808, barómetro y DHT11 en setup()
    - Fallback automático a simulación con drift lento por sensor fallido
    - Rediseño completo de la pantalla para LilyGo T-Display-S3 (320×170)
    - TFT_eSprite doble buffer para renderizado sin parpadeo
    - Cuadrícula 2×3: T.EXT / T.INT / HUMEDAD / PRESIÓN / VIENTO / DIRECCIÓN
    - Iconos dibujados con primitivas TFT (termómetro, gota, manómetro, viento, brújula)
    - Badge [OK] verde / [SIM] naranja por tarjeta
    - Pantalla de arranque mostrando estado de cada sensor antes del dashboard
    - Firmware reorganizado en subcarpeta ESP_monitor_server/ (estructu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
    [ESP_monitor_server.ino]
2026-03-13 Fix: añadir declaraciones de ssid/password/server_ip/server_port y quitar #define ESP32 redundante
    [ESP_monitor_server.ino]
2026-03-16 Firmware compatible ESP32 y ESP8266 con ifdef condicionales
2026-03-16 Integra sensor TSL2584 (lux), CSV pasa a 9 valores
2026-03-16 TSL2584: usa WORD mode (0x20) para leer CH0/CH1 correctamente
    [ESP_monitor_server.ino]
2026-03-16 TSL2584 debug: lectura separada por byte + dump de registros
2026-03-16 TSL: repeated start I2C + dump de registros clave con identificacion de chip
2026-03-16 Corrige warning ambiguous overload en Wire.requestFrom
    [ESP_monitor_server.ino]
2026-03-16 Agrega escaner I2C en boot para identificar dispositivos en el bus
2026-03-16 Autodetecta APDS-9930 vs TSL2584 por registro ID
    - Lee reg 0x12 en boot: si devuelve 0x39 usa registros APDS-9930 (0x14-0x17)
    - Si no, asume TSL2584 y usa registros originales (0x0C-0x0F)
    - Revierte endTransmission(false) a stop-start, más estable en ESP8266
    - Elimina tsl_dumpRegs() que colgaba el bus I2C al leer registros reservados
2026-03-16 Mejora deteccion sensor luz: acepta APDS rev0/rev1, fallback APDS
    - Imprime ID@0x12 e ID@0x0A para diagnostico
    - Acepta nibble alto 0x3 (cubre 0x30 y 0x39) para APDS-9930
    - Si ID no coincide con ninguno, usa registros APDS como fallback
2026-03-16 Añade PINOUT.md con conexiones ESP8266 y ESP32
2026-03-17 Reemplaza DHT11 por HTU2x (I2C 0x40) para temperatura y humedad
    - Elimina DHTesp y DHTPIN: el HTU21D/HTU20D opera por I2C
    - Implementacion directa sin librería: no-hold master, formulas del datasheet
    - Mismo formato CSV (9 valores), mismas variables internas
    - htu_ok reemplaza dht_ok en flags y display
2026-03-17 Añade OTA (ArduinoOTA) y corrige SERVER_PORT a 7000
    - ArduinoOTA integrado en ESP8266 y ESP32
    - Hostname: meteostation-esp8266 / meteostation-esp32
    - Contraseña OTA opcional via OTA_PASSWORD en secrets.h
    - ArduinoOTA.handle() como primera instruccion del loop
    - OTA solo se inicializa si WiFi conecta
    - SERVER_PORT corregido de 5000 → 7000 en secrets.h
    [ESP_monitor_server.ino]
2026-03-17 Añade DHT11 junto a HTU2x — CSV 9→11 valores
    - Setup: inicializa DHT11 (pin D5/15) con DHTesp, lectura inicial
    - Loop 1s: lee DHT11 en cada ciclo, fallback a simulacion si falla
    - CSV ampliado a 11 campos: ...luz, dht11_temperatura, dht11_humedad
    - Serial debug actualizado para incluir D11T y D11H
2026-03-17 Añade script ota_flash.sh para flashear desde WSL sin instalar Arduino
2026-03-17 Firmware v3: CSV 14 campos, postDeviceInfo, pantalla TFT corregida
    - CSV ampliado a 14 campos: +rssi, +free_heap, +uptime_s (retrocompat. 9/11)
    - Nueva función postDeviceInfo(): POST a /api/device_info al arrancar
    con chip_model, chip_revision, cpu_freq_mhz, flash_size_mb, sdk, mac, ip
    - TFT_eSPI: configuración corregida a Setup25_TTGO_T_Display (ST7789 240×135)
    - README: reescrito completo con board correcto, OTA, librerías, algoritmos
    - PINOUT.md: añadido HTU2x y DHT11 a ambas variantes; board ESP32 corregido
    - BOM_HARDWARE.md: lista completa de materiales con precios orientativos
    [ESP_monitor_server.ino]
2026-03-23 Firmware v4: HTTPS producción (meteo.aquantialab.com) + calefactor HTU2x
    - secrets.h: SERVER_IP → meteo.aquantialab.com, SERVER_PORT → 443
    - WiFiClientSecure + setInsecure() en httpPost y postDeviceInfo (ESP32)
    - URLs actualizadas a https:// sin puerto explícito
    - HTU2x: calentamiento de arranque 3s (htu_heater_warmup) para evaporar
    condensación y mejorar fiabilidad de humedad desde el inicio
    - ota_flash.sh: convertido a LF (era CRLF)
    - README: refleja despliegue en producción, secrets.h de ejemplo actualizado,
    sección OTA simplificada con hostname mDNS
2026-03-23 Fix: evitar reset por watchdog en boot con HTTPS
    - postDeviceInfo() movido del setup() al loop (primera iteración con WiFi)
    para no bloquear el boot con el handshake TLS
    - Timeout HTTP 3s → 10s en httpPost y postDeviceInfo
    - Añadido client.setHandshakeTimeout(10) en ambas funciones ESP32
    [ESP_monitor_server.ino]
2026-03-23 Fix: crash InstrFetchProhibited por orden de destrucción de WiFiClientSecure
    Declarar WiFiClientSecure/WiFiClient antes que HTTPClient en postDeviceInfo()
    y httpPost() para que http se destruya antes que client (que guarda su ref).
    Evita PC=0x00000000 tras el POST de DeviceInfo en cada boot.
    También migra ota_flash.sh a compilación con arduino-cli desde WSL,
    eliminando la dependencia del Arduino IDE de Windows.
    [ESP_monitor_server.ino]
2026-03-23 Ahorro de energía: Modem Sleep + pantalla con timeout 60s + botones
    - WiFi.setSleep(true) tras OTA.begin() → ahorra ~15-20mA entre transmisiones
    - Pantalla se apaga sola tras 60s de inactividad (GPIO 4 backlight)
    - Botón izquierdo (GPIO 0) o derecho (GPIO 35) enciende la pantalla de nuevo
2026-03-23 Reducir CPU a 80MHz — ahorro energía significativo
    setCpuFrequencyMhz(80) en boot: de 0.108W a 0.007W en reposo,
    0.020W enviando. Autonomía estimada ~7 meses con power bank 10000mAh.
2026-03-25 feat: relay polling cada 2s para activación casi inmediata desde dashboard
2026-03-25 fix: ota_flash.sh compatible con Windows/WSL (arduino-cli IDE, Python auto-detect)
2026-03-25 fix: ignorar binarios compilados del firmware (build/)
    [partitions.csv]
2026-03-26 chore: eliminar binarios compilados del índice git
    Los ficheros build/ estaban trackeados antes de añadir la regla
    en .gitignore. Se eliminan del índice para que futuros compilados
    no aparezcan como cambios pendientes.
    [partitions.csv]
2026-03-26 fix: enviar ACK inmediato al servidor tras cambio de estado del relay
    Tras activar/desactivar el relay en checkRelayCommand(), se hace POST
    a /api/relay/ack con "1" o "0" sin esperar el ciclo de envío de 20s.
    Reduce la latencia de confirmación en el dashboard de ~20s a ~2s.
    [ESP_monitor_server.ino]
2026-03-27 fix: invertir lógica relay — activo-HIGH en vez de activo-LOW
    El hardware usa señal HIGH para activar el relay (válvula abierta)
    y LOW para desactivarlo. Se corrigen checkRelayCommand() y el estado
    inicial de arranque.
    [ESP_monitor_server.ino]
2026-03-27 feat: simulador pipeline integrado en firmware — presión y caudal por CSV
    - Constantes físicas: PIPELINE_STATIC_P=3.5 bar, PIPELINE_DYNAMIC_P=2.8 bar
    - pipelineNoise(): ruido determinista con ondas sinusoidales del timestamp,
    idéntico al algoritmo de pipeline_sim.py para comparación directa
    - updatePipelineSimValues(): genera presión y caudal según estado del relay
    y escenario consultado desde GET /api/pipeline/scenario
    - Escenarios: normal / leak (~0.28 L/min fuga) / burst (P colapsa ~0.25 bar)
    - CSV ampliado de 15 a 17 campos: campo 15=pipeline_pressure, 16=pipeline_flow
    - README: sección Pipeline + tabla CSV actualizada a 17 campos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
    [ESP_monitor_server.ino]
2026-03-29 feat: añadir header X-Device-MAC en cada POST al servidor
    Incluye la MAC del dispositivo como header HTTP en httpPost() para
    que el backend identifique el ESP sin depender de la IP (DHCP).
    Actualiza ota_flash.sh con rutas correctas para Windows (Arduino IDE 2.x).
    [ESP_monitor_server.ino]
2026-03-30 feat: multi-relay support via DEVICE_PROFILE compile-time define
    - PROFILE_METEO (default): 1 relay on RELAY_PIN
    - PROFILE_IRRIGATION: 4 relays on RELAY_PINS[] (GPIO 26/25/33/32)
    - relay_active CSV field now encodes bitmask (bit N = relay N)
    - checkRelayCommand() reads bitmask from /api/relay/command?mac=
    - sendDeviceInfo() reports relay_count to backend
    - httpPost() already sends X-Device-MAC header
    - Set #define DEVICE_PROFILE PROFILE_IRRIGATION in secrets.h on the 4-relay device
2026-03-30 feat: sensor YL-69 humedad suelo en GPIO 33 (campo 16 CSV)
    - SOIL_PIN 33 (ADC1_CH5, solo ESP32)
    - Lectura en setup() y loop 1s: analogRead invertido a 0-100%
    - Valor simulado con drift para ESP8266 / sensor desconectado
    - Campo 16 añadido al POST cada 20s
    [ESP_monitor_server.ino]
2026-03-30 fix: calibración YL-69 con puntos reales + fix ping Windows en ota_flash.sh
    - SOIL_RAW_DRY=4094, SOIL_RAW_WET=3530 medidos en campo
    - ota_flash.sh: ping compatible con Linux y Git Bash/Windows
    [ESP_monitor_server.ino]
2026-03-30 fix: ota_flash.sh compatible Linux/Windows + pinMode SOIL_PIN ADC setup
    - ota_flash.sh ahora detecta OS automáticamente (Linux usa /tmp, ~/.arduino15,
    arduino-cli en PATH; Windows mantiene rutas anteriores)
    - setup(): añade pinMode(SOIL_PIN, INPUT) + analogSetPinAttenuation(ADC_11db)
    para garantizar lectura analógica correcta en GPIO 33
    [ESP_monitor_server.ino]
2026-03-30 feat: ota_flash.sh añade --upload-only para saltar compilación
2026-03-31 fix: increase CPU frequency to improve performance during setup
    [ESP_monitor_server.ino]
2026-04-01 feat: refactor firmware v4 — FreeRTOS dual-core, perfiles METEO/IRRIGATION, fix relays
    Arquitectura:
    - FreeRTOS: sensores/display en Core 1 (loop), red en Core 0 (networkTask)
    - networkTask gestiona OTA, relay polling y HTTP POST sin bloquear sensores
    - dataMutex protege snapshot de datos entre cores; windMux para acumuladores de viento
    - isUpdatingOTA suspende HTTP y pone relays en OFF durante flash
    Perfiles de dispositivo (DEVICE_PROFILE vía build flag):
    - PROFILE_METEO (1): LilyGo TTGO T-Display — 1 relay GPIO26, pantalla, YL-69 GPIO33
    - PROFILE_IRRIGATION (2): ESP32 4-Relay Board — 4 relays GPIO32/33/25/26, sin pantalla
    Correcciones:
    - Fix bug crítico relay activo-LOW: setup()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
    [ESP_monitor_server.ino]
2026-04-01 fix: mover declaración windMux antes de accumulateWindVector
    windMux se usaba en accumulateWindVector/calcAndResetWindVector pero
    se declaraba después — el compilador no lo encontraba en scope.
    [ESP_monitor_server.ino]
